TheEccentricGenius/UNO4u_Board/UNO-128DA28.kicad_sch

## KiCad design UNO-128DA28.kicad_sch (2024-09-03)

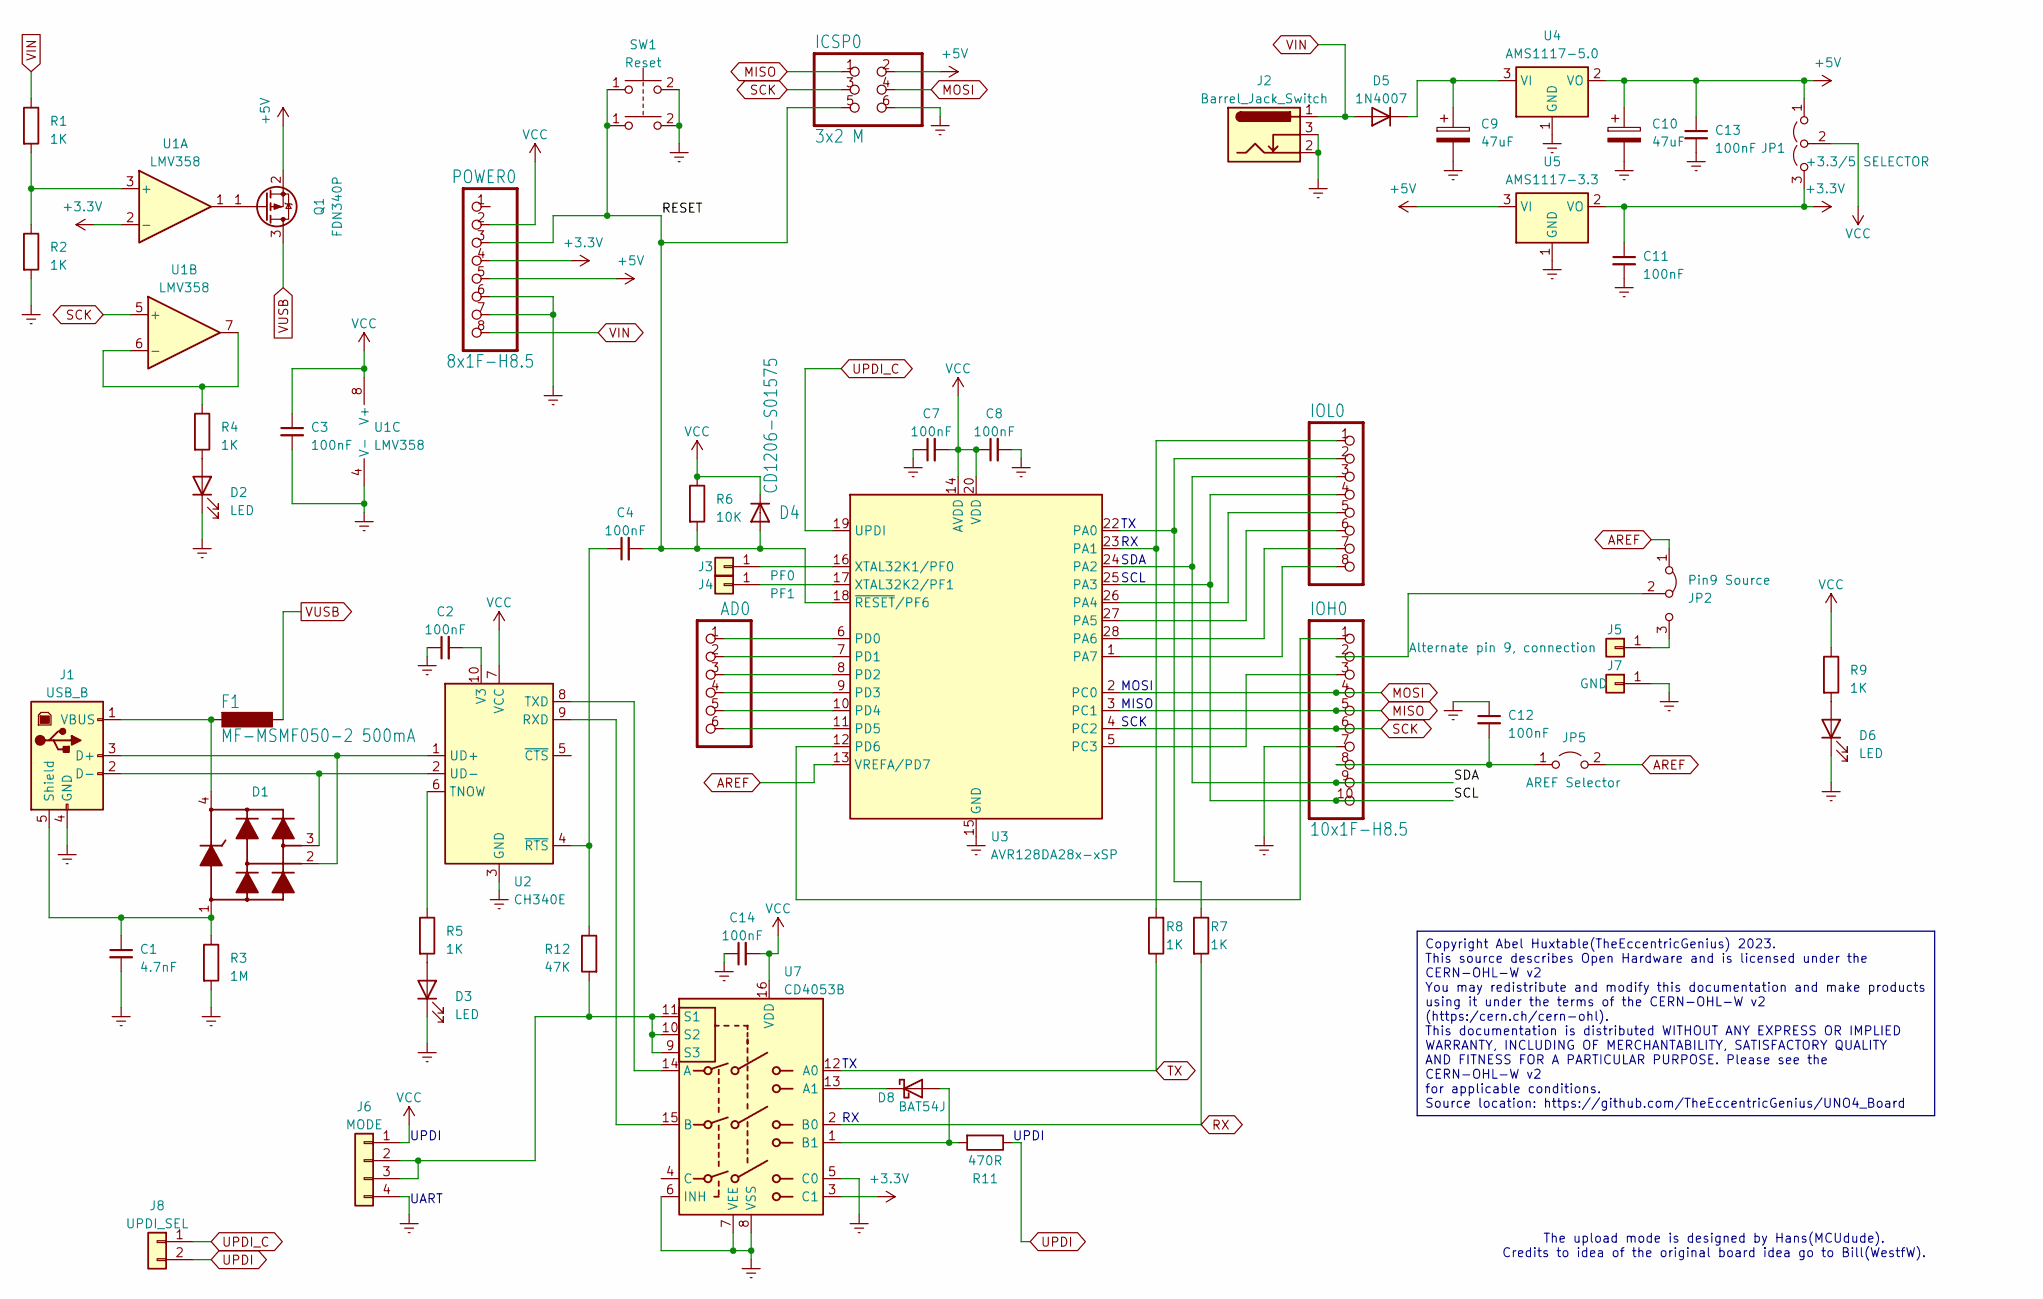
[picture p1: schematic UNO-128DA28.kicad_sch]

Parts:
AD0: 6x1F-H8.5; PinSocket_1x06_P2.54mm_Vertical
C1: 4.7nF; C_0805_2012Metric_Pad1.18x1.45mm_HandSolder
C2, C3, C4, C7, C8, C11, C12, C13, C14: 100nF; C_0603_1608Metric_Pad1.08x0.95mm_HandSolder
C9, C10: 47uF; CP_Radial_D5.0mm_P2.50mm
D1: PRTR5V0U2X,215; SOT-143_Handsoldering; PART NUMBER PRTR5V0U2X,215
D2, D3, D6: LED; LED_0805_2012Metric_Pad1.15x1.40mm_HandSolder
D4: CD1206-S01575; MINIMELF
D5: 1N4007; D_DO-41_SOD81_P10.16mm_Horizontal
D8: BAT54J; D_SOD-323F
F1: MF-MSMF050-2 500mA; Fuse_1812_4532Metric_Pad1.30x3.40mm_HandSolder
ICSP0: 3x2 M; PinHeader_2x03_P2.54mm_Vertical
IOH0: 10x1F-H8.5; PinSocket_1x10_P2.54mm_Vertical
IOL0: 8x1F-H8.5; PinSocket_1x08_P2.54mm_Vertical
J1: USB_B
J2: Barrel_Jack_Switch; BarrelJack
J3: PF0; SolderWirePad_1x01_SMD_1x2mm
J4: PF1; SolderWirePad_1x01_SMD_1x2mm
J5: Alternate pin 9, connection; SolderWirePad_1x01_SMD_1x2mm
J6: MODE; PinHeader_1x04_P2.54mm_Vertical
J7: GND; SolderWirePad_1x01_SMD_1x2mm
J8: UPDI_SEL; PinHeader_1x02_P2.54mm_Vertical
JP1: +3.3/5 SELECTOR; SolderJumper-3_P1.3mm_Bridged12_RoundedPad1.0x1.5mm
JP2: Pin9 Source; SolderJumper-3_P1.3mm_Bridged12_RoundedPad1.0x1.5mm
JP5: AREF Selector; SolderJumper-2_P1.3mm_Open_RoundedPad1.0x1.5mm
POWER0: 8x1F-H8.5; PinSocket_1x08_P2.54mm_Vertical
Q1: FDN340P; SOT-23
R1, R2, R4, R5, R7, R8, R9: 1K; R_0603_1608Metric_Pad0.98x0.95mm_HandSolder
R3: 1M; R_0603_1608Metric_Pad0.98x0.95mm_HandSolder
R6: 10K; R_0603_1608Metric_Pad0.98x0.95mm_HandSolder
R11: 470R; R_0603_1608Metric_Pad0.98x0.95mm_HandSolder
R12: 47K; R_0603_1608Metric_Pad0.98x0.95mm_HandSolder
SW1: Reset; SW_PUSH_6mm
U1: LMV358; SO-8_3.9x4.9mm_P1.27mm
U2: CH340E; MSOP-10_3x3mm_P0.5mm
U3: AVR128DA28x-xSP; DIP-28_W7.62mm
U4: AMS1117-5.0; SOT-223-3_TabPin2
U5: AMS1117-3.3; SOT-223-3_TabPin2
U7: CD4053B; TSSOP-16_4.4x5mm_P0.65mm

Connections:
+3.3V: C11.1, JP1.3 (B), POWER0.4, U1.2 (-), U5.2 (VO), U7.3 (C1)
+5V: C10.1, C13.1, ICSP0.2, JP1.1 (A), POWER0.5, Q1.2 (S), U4.2 (VO), U5.3 (VI)
AREF: JP2.1 (A), JP5.2 (B), U3.13 (VREFA/PD7)
Earth: C1.2, C2.1, C3.2, C7.1, C8.2, C9.2, C10.2, C11.2, C12.1, C13.2, C14.1, D2.1 (K), D3.1 (K), D6.1 (K), ICSP0.6, IOH0.7, J1.4 (GND), J2.2, J2.3, J6.4, J7.1, POWER0.6, POWER0.7, R2.2, R3.2, SW1.2, U1.4 (V-), U2.3 (GND), U3.15 (GND), U3.21 (GND), U4.1 (GND), U5.1 (GND), U7.5 (C0), U7.6 (INH), U7.7 (VEE), U7.8 (VSS)
MISO: ICSP0.1, IOH0.5, U3.3 (PC1)
MOSI: ICSP0.4, IOH0.4, U3.2 (PC0)
unnamed: AD0.1, U3.6 (PD0)
unnamed: AD0.2, U3.7 (PD1)
unnamed: AD0.3, U3.8 (PD2)
unnamed: AD0.4, U3.9 (PD3)
unnamed: AD0.5, U3.10 (PD4)
unnamed: AD0.6, U3.11 (PD5)
unnamed: C1.1, D1.1, J1.5 (Shield), R3.1
unnamed: C2.2, U2.10 (V3)
unnamed: C4.1, R12.1, U2.4 (~RTS)
unnamed: C9.1, D5.1 (K), U4.3 (VI)
unnamed: C12.2, IOH0.8, JP5.1 (A)
unnamed: D1.2, J1.3 (D+), U2.1 (UD+)
unnamed: D1.3, J1.2 (D-), U2.2 (UD-)
unnamed: D1.4, F1.2, J1.1 (VBUS)
unnamed: D2.2 (A), R4.2
unnamed: D3.2 (A), R5.2
unnamed: D6.2 (A), R9.2
unnamed: D8.1 (K), U7.13 (A1)
unnamed: D8.2 (A), R11.2, U7.1 (B1)
unnamed: IOH0.1, U3.12 (PD6)
unnamed: IOH0.2, JP2.2 (C)
unnamed: IOH0.3, U3.5 (PC3)
unnamed: IOL0.1, R8.2, U3.23 (PA1)
unnamed: IOL0.2, R7.1, U3.22 (PA0)
unnamed: IOL0.5, U3.26 (PA4)
unnamed: IOL0.6, U3.27 (PA5)
unnamed: IOL0.7, U3.28 (PA6)
unnamed: IOL0.8, U3.1 (PA7)
unnamed: J3.1, U3.16 (XTAL32K1/PF0)
unnamed: J4.1, U3.17 (XTAL32K2/PF1)
unnamed: J5.1, JP2.3 (B)
unnamed: J6.2, J6.3, R12.2, U7.9 (S3), U7.10 (S2), U7.11 (S1)
unnamed: Q1.1 (G), U1.1
unnamed: R1.2, R2.1, U1.3 (+)
unnamed: R4.1, U1.6 (-), U1.7
unnamed: R5.1, U2.6 (TNOW)
unnamed: U2.8 (TXD), U7.14 (A)
unnamed: U2.9 (RXD), U7.15 (B)
RESET: C4.2, D4.A, ICSP0.5, POWER0.3, R6.2, SW1.1, U3.18 (~RESET/PF6)
RX: R7.2, U7.2 (B0)
SCK: ICSP0.3, IOH0.6, U1.5 (+), U3.4 (PC2)
SCL: IOH0.10, IOL0.4, U3.25 (PA3)
SDA: IOH0.9, IOL0.3, U3.24 (PA2)
TX: R8.1, U7.12 (A0)
UPDI: J8.2, R11.1
UPDI_C: J8.1, U3.19 (UPDI)
VCC: C3.1, C7.2, C8.1, C14.2, D4.C, J6.1, JP1.2 (C), POWER0.2, R6.1, R9.1, U1.8 (V+), U2.7 (VCC), U3.14 (AVDD), U3.20 (VDD), U7.16 (VDD)
VIN: D5.2 (A), J2.1, POWER0.8, R1.1
VUSB: F1.1, Q1.3 (D)

Notes on the sheet:
Copyright Abel Huxtable(TheEccentricGenius) 2023. This source describes Open Hardware and is licensed under the CERN-OHL-W v2 You may redistribute and modify this documentation and make products using it under the terms of the CERN-OHL-W v2 (https:/cern.ch/cern-ohl). This documentation is distribut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
UART
SCK
SDA
MISO
SCL
UPDI
MOSI
The upload mode is designed by Hans(MCUdude). Credits to idea of the original board idea go to Bill(WestfW).
