TheEccentricGenius/UNO4u_Board/Changes.txt

03/09/24: Added credits to the schematic and PCB design, thanking MCUdude and WestfW.

24/09/23: License updating done.
23/09/23: Licensing to hopefully be inforced better. e.g. Abel Huxtable(TheEccentricGenius) instead of TheEccentricGenius.
          Planned for 24/09/23.

None: initial release.
