TheEccentricGenius/UNO4u_Board/(commit log)

2023-08-20 Initial commit.
    [UNO-128DA28-B_Cu.gbr, UNO-128DA28-B_Mask.gbr, UNO-128DA28-B_Paste.gbr, UNO-128DA28-B_Silkscreen.gbr, UNO-128DA28-Edge_Cuts.gbr, UNO-128DA28-F_Cu.gbr, UNO-128DA28-F_Mask.gbr, UNO-128DA28-F_Paste.gbr]
2023-09-24 Updating UNO-128DA28.kicad_pcb
2023-09-24 Updated licensing....
    [UNO-128DA28.kicad_sch]
2024-09-03 Updated all the files.
    Credits added to the original idea people.
    [UNO-128DA28.kicad_sch]
